askinkeles/Industrial-RS485-AutoFlow/Assets/pcb_layout_2d.png

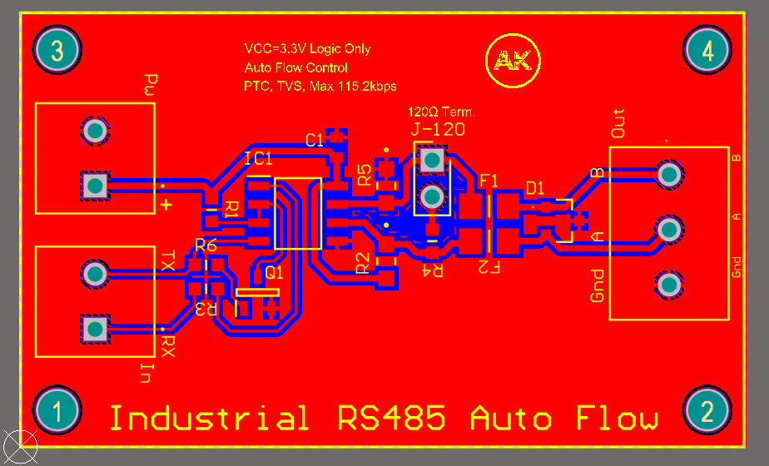
Assets/pcb_layout_2d.png
