askinkeles/Industrial-RS485-AutoFlow/Assets/pcb_view_3d.png

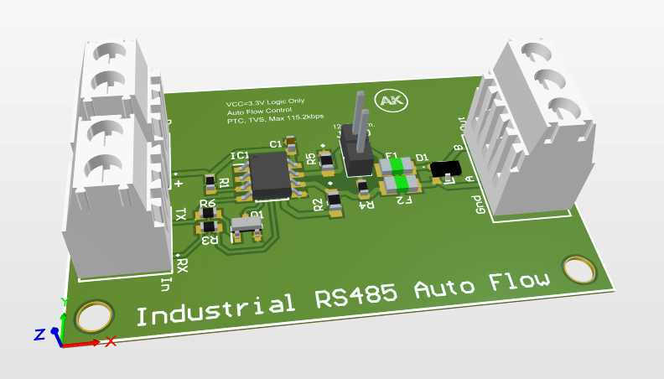
Assets/pcb_view_3d.png
