askinkeles/Industrial-RS485-AutoFlow/Assets/schematic_full.png

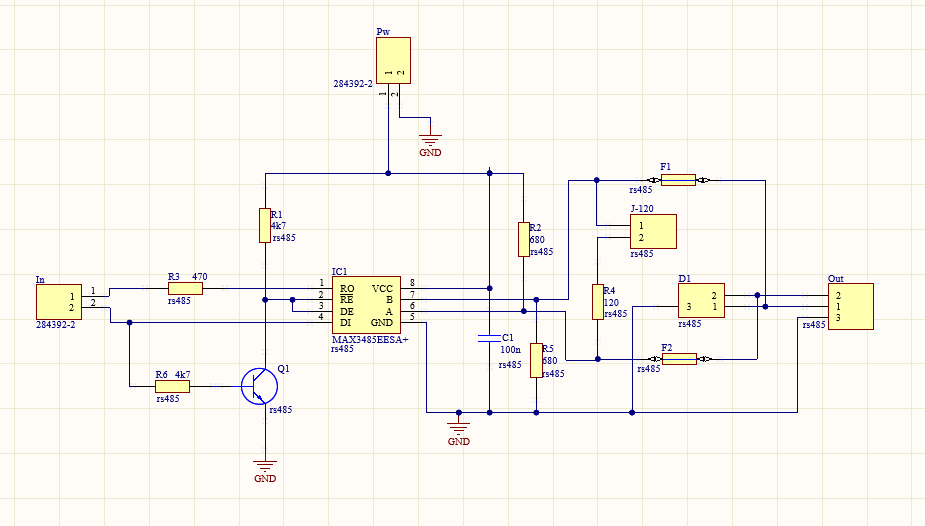
Assets/schematic_full.png
