askinkeles/Industrial-RS485-AutoFlow/(notices)

Notices in the files:
README.md:
License: MIT
